GadgetReboot/SoundLogic/README.md

# SoundLogic
Sound Generator Based on 555 and Digital Logic
