GadgetReboot/SoundLogic/GR_SoundLogic_Sch.pdf

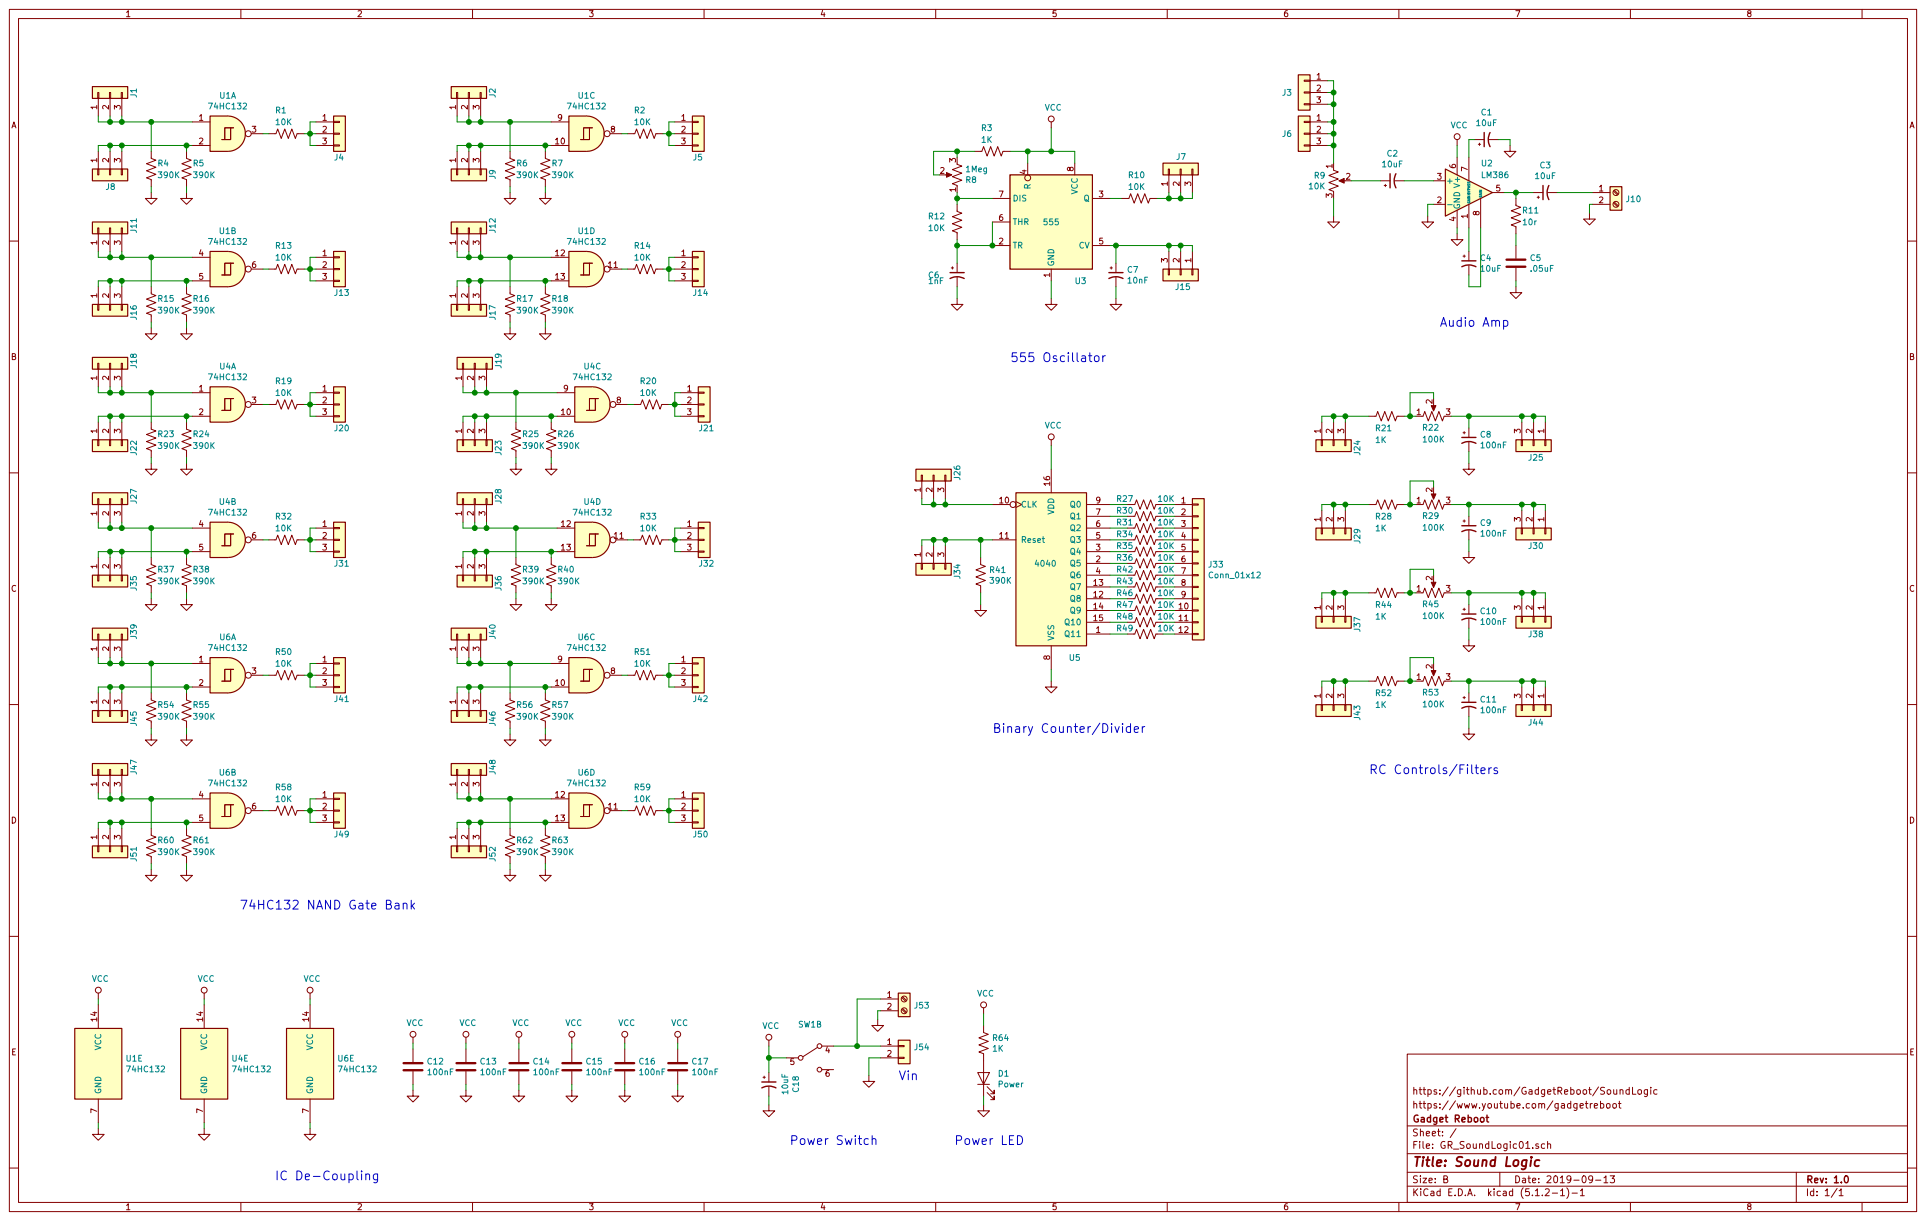
[picture p1: page 1]

https://github.com/GadgetReboot/SoundLogic R64

https://www.youtube.com/gadgetreboot
File: GR_SoundLogic01.sch Sheet: / Gadget Reboot

Id: 1/1 Title: Sound Logic
