GadgetReboot/SoundLogic/KiCAD/GR_SoundLogic01.kicad_pcb

## KiCad design KiCAD/GR_SoundLogic01.kicad_pcb (2019-10-04)

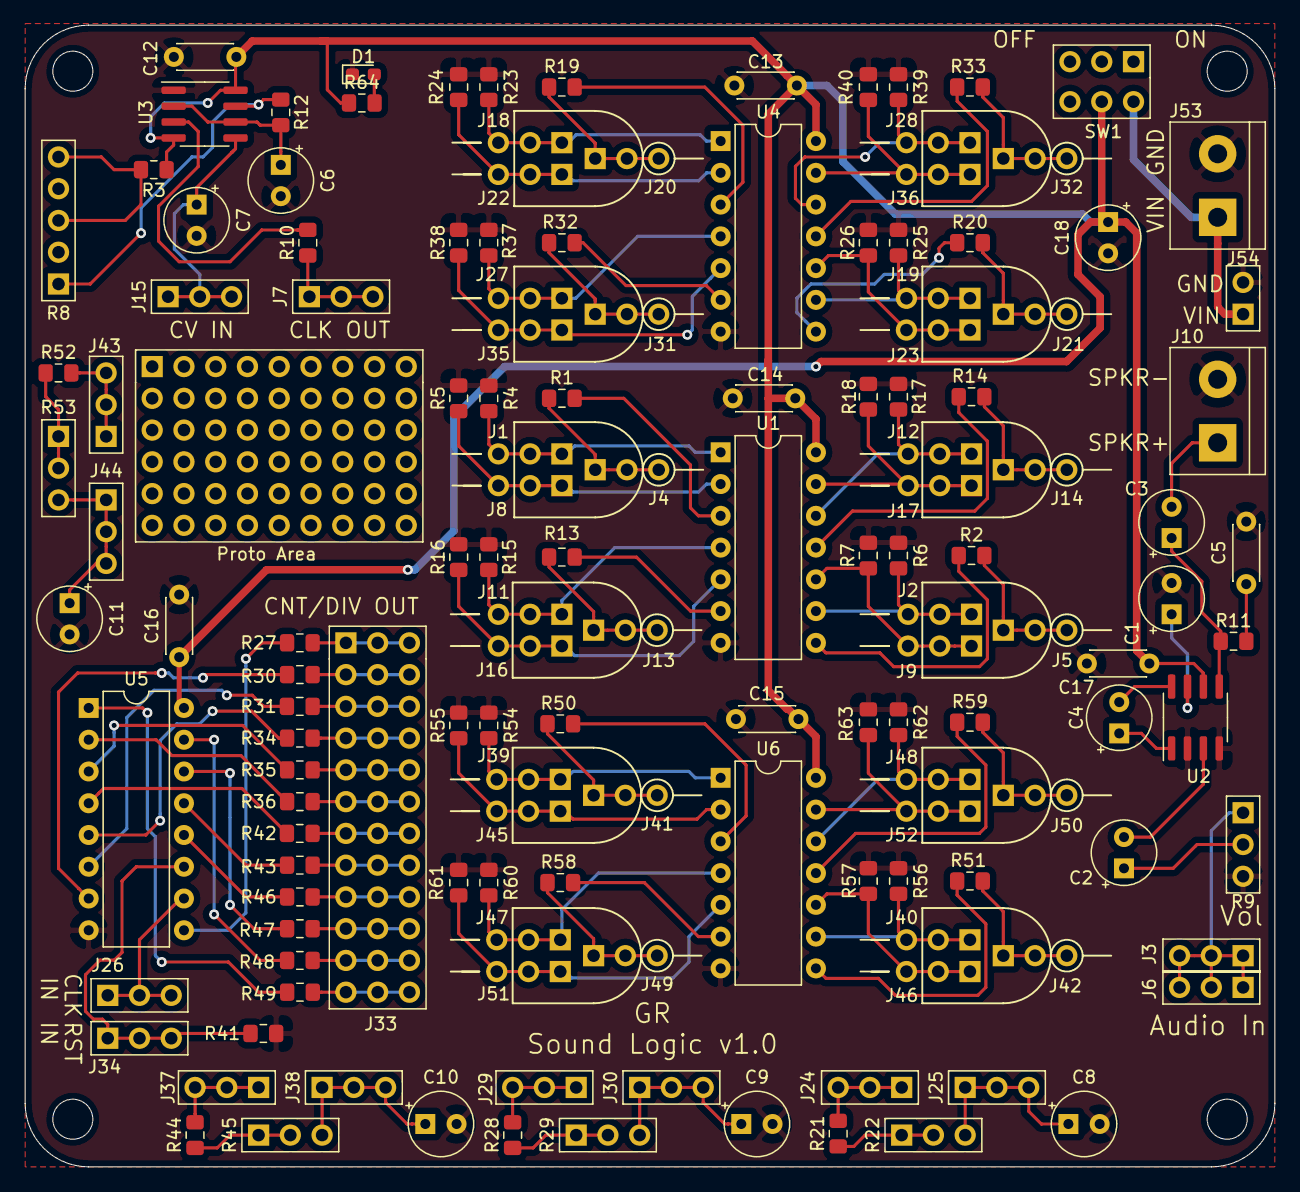
[picture p2: board GR_SoundLogic01.kicad_pcb from above]

Board: 2 copper layers, 99.9 x 91.3 mm, 145 parts (0 on the bottom side), 105 nets.

Parts:
C1, C2, C3, C4, C6, C7, C8, C9, C10, C11, C18: 10uF; CP_Radial_Tantal_D5.0mm_P2.50mm
C5: .05uF; C_Disc_D4.3mm_W1.9mm_P5.00mm
C12, C13, C14, C15, C16, C17: 100nF; C_Disc_D4.3mm_W1.9mm_P5.00mm
D1: Power; LED_0603_1608Metric_Pad1.05x0.95mm_HandSolder
J1, J2, J4, J5, J8, J9, J11, J12, J13, J14, J16, J17, J18, J19, J20, J21, J22, J23, J27, J28, J31, J32, J35, J36, J39, J40, J41, J42, J45, J46, J47, J48, J49, J50, J51, J52: 1x3; PinHeader_1x03_P2.54mm_Vertical_NoSilk_H1.0mm
J3, J6, J7, J15, J24, J25, J26, J29, J30, J34, J37, J38, J43, J44: 1x3; PinHeader_1x03_P2.54mm_Vertical_H1.0mm
J10, J53: Screw_Terminal_01x02; TerminalBlock_bornier-2_P5.08mm
J33: Conn_01x12; PinHeader_3x12_P2.54mm_Vertical
J54: 1x2; PinHeader_1x02_P2.54mm_Vertical_H1.0mm
Proto Area: PinHeader_6x9_P2.54mm
R1, R2, R10, R13, R14, R19, R20, R27, R30, R31, R32, R33, R34, R35, R36, R42, R43, R46, R47, R48, R49, R50, R51, R58, R59: 10K; R_0805_2012Metric_Pad1.15x1.40mm_HandSolder
R3, R12, R41, R64: 4.7K; R_0805_2012Metric_Pad1.15x1.40mm_HandSolder
R4, R5, R6, R7, R15, R16, R17, R18, R23, R24, R25, R26, R37, R38, R39, R40, R54, R55, R56, R57, R60, R61, R62, R63: 1Meg; R_0805_2012Metric_Pad1.15x1.40mm_HandSolder
R8: 100K; Pot_1x05_P2.54mm_H1.0mm
R9: 10K; PinHeader_1x03_P2.54mm_Vertical_H1.0mm
R11: 10r; R_0805_2012Metric_Pad1.15x1.40mm_HandSolder
R21, R28, R44, R52: 1K; R_0805_2012Metric_Pad1.15x1.40mm_HandSolder
R22, R29, R45, R53: 100K; PinHeader_1x03_P2.54mm_Vertical_H1.0mm
SW1: SW_DPDT_x2; SlideSwitch_2x03_P2.54x3.2mm
U1, U4, U6: 74HC132; DIP-14_W7.62mm
U2: LM386; SOIC-8_3.9x4.9mm_P1.27mm
U3: 555; SOIC-8_3.9x4.9mm_P1.27mm
U5: 4040; DIP-16_W7.62mm

Connections:
GND: C1.2, C5.2, C6.2, C7.2, C8.2, C9.2, C10.2, C11.2, C12.2, C13.2, C14.2, C15.2, C16.2, C17.2, C18.2, D1.1, J10.2, J53.2, J54.2, R4.2, R5.2, R6.2, R7.2, R9.3, R15.2, R16.2, R17.2, R18.2, R23.2, R24.2, R25.2, R26.2, R37.2, R38.2, R39.2, R40.2, R41.2, R54.2, R55.2, R56.2, R57.2, R60.2, R61.2, R62.2, R63.2, U1.7, U2.2, U2.4, U3.1, U4.7, U5.8, U6.7
unnamed: C1.1, U2.7
unnamed: C2.1, R9.2
unnamed: C2.2, U2.3
unnamed: C3.1, R11.1, U2.5
unnamed: C3.2, J10.1
unnamed: C4.1, U2.1
unnamed: C4.2, U2.8
unnamed: C5.1, R11.2
unnamed: C6.1, R12.2, U3.2, U3.6
unnamed: C7.1, J15.1, J15.2, J15.3, U3.5
unnamed: C8.1, J25.1, J25.2, J25.3, R22.3
unnamed: C9.1, J30.1, J30.2, J30.3, R29.3
unnamed: C10.1, J38.1, J38.2, J38.3, R45.3
unnamed: C11.1, J44.1, J44.2, J44.3, R53.3
unnamed: D1.2, R64.2
unnamed: J1.1, J1.2, J1.3, R4.1, U1.1
unnamed: J2.1, J2.2, J2.3, R6.1, U1.9
unnamed: J3.1, J3.2, J3.3, J6.1, J6.2, J6.3, R9.1
unnamed: J4.1, J4.2, J4.3, R1.1
unnamed: J5.1, J5.2, J5.3, R2.1
unnamed: J7.1, J7.2, J7.3, R10.1
unnamed: J8.1, J8.2, J8.3, R5.1, U1.2
unnamed: J9.1, J9.2, J9.3, R7.1, U1.10
unnamed: J11.1, J11.2, J11.3, R15.1, U1.4
unnamed: J12.1, J12.2, J12.3, R17.1, U1.12
unnamed: J13.1, J13.2, J13.3, R13.1
unnamed: J14.1, J14.2, J14.3, R14.1
unnamed: J16.1, J16.2, J16.3, R16.1, U1.5
unnamed: J17.1, J17.2, J17.3, R18.1, U1.13
unnamed: J18.1, J18.2, J18.3, R23.1, U4.1
unnamed: J19.1, J19.2, J19.3, R25.1, U4.9
unnamed: J20.1, J20.2, J20.3, R19.1
unnamed: J21.1, J21.2, J21.3, R20.1
unnamed: J22.1, J22.2, J22.3, R24.1, U4.2
unnamed: J23.1, J23.2, J23.3, R26.1, U4.10
unnamed: J24.1, J24.2, J24.3, R21.2
unnamed: J26.1, J26.2, J26.3, U5.10
unnamed: J27.1, J27.2, J27.3, R37.1, U4.4
unnamed: J28.1, J28.2, J28.3, R39.1, U4.12
unnamed: J29.1, J29.2, J29.3, R28.2
unnamed: J31.1, J31.2, J31.3, R32.1
unnamed: J32.1, J32.2, J32.3, R33.1
unnamed: J33.1, R27.1
unnamed: J33.2, R30.1
unnamed: J33.3, R31.1
unnamed: J33.4, R34.1
unnamed: J33.5, R35.1
unnamed: J33.6, R36.1
unnamed: J33.7, R42.1
unnamed: J33.8, R43.1
unnamed: J33.9, R46.1
unnamed: J33.10, R47.1
unnamed: J33.11, R48.1
unnamed: J33.12, R49.1
unnamed: J34.1, J34.2, J34.3, R41.1, U5.11
unnamed: J35.1, J35.2, J35.3, R38.1, U4.5
unnamed: J36.1, J36.2, J36.3, R40.1, U4.13
unnamed: J37.1, J37.2, J37.3, R44.2
unnamed: J39.1, J39.2, J39.3, R54.1, U6.1
unnamed: J40.1, J40.2, J40.3, R56.1, U6.9
unnamed: J41.1, J41.2, J41.3, R50.1
unnamed: J42.1, J42.2, J42.3, R51.1
unnamed: J43.1, J43.2, J43.3, R52.2
unnamed: J45.1, J45.2, J45.3, R55.1, U6.2
unnamed: J46.1, J46.2, J46.3, R57.1, U6.10
unnamed: J47.1, J47.2, J47.3, R60.1, U6.4
unnamed: J48.1, J48.2, J48.3, R62.1, U6.12
unnamed: J49.1, J49.2, J49.3, R58.1
unnamed: J50.1, J50.2, J50.3, R59.1
unnamed: J51.1, J51.2, J51.3, R61.1, U6.5
unnamed: J52.1, J52.2, J52.3, R63.1, U6.13
unnamed: J53.1, J54.1, SW1.4
unnamed: R1.2, U1.3
unnamed: R2.2, U1.8
unnamed: R3.2, R8.2, R8.3
unnamed: R10.2, U3.3
unnamed: R8.1, R12.1, U3.7
unnamed: R13.2, U1.6
unnamed: R14.2, U1.11
unnamed: R19.2, U4.3
unnamed: R20.2, U4.8
unnamed: R21.1, R22.1, R22.2
unnamed: R27.2, U5.9
unnamed: R28.1, R29.1, R29.2
unnamed: R30.2, U5.7
unnamed: R31.2, U5.6
unnamed: R32.2, U4.6
unnamed: R33.2, U4.11
unnamed: R34.2, U5.5
unnamed: R35.2, U5.3
unnamed: R36.2, U5.2
unnamed: R42.2, U5.4
unnamed: R43.2, U5.13
unnamed: R44.1, R45.1, R45.2
unnamed: R46.2, U5.12
unnamed: R47.2, U5.14
unnamed: R48.2, U5.15
unnamed: R49.2, U5.1
unnamed: R50.2, U6.3
unnamed: R51.2, U6.8
unnamed: R52.1, R53.1, R53.2
unnamed: R58.2, U6.6
unnamed: R59.2, U6.11
VCC: C12.1, C13.1, C14.1, C15.1, C16.1, C17.1, C18.1, R3.1, R64.1, SW1.5, U1.14, U2.6, U3.4, U3.8, U4.14, U5.16, U6.14
